NathanJustus/AmoeBotControl/Figures/amoeBotTesting.png

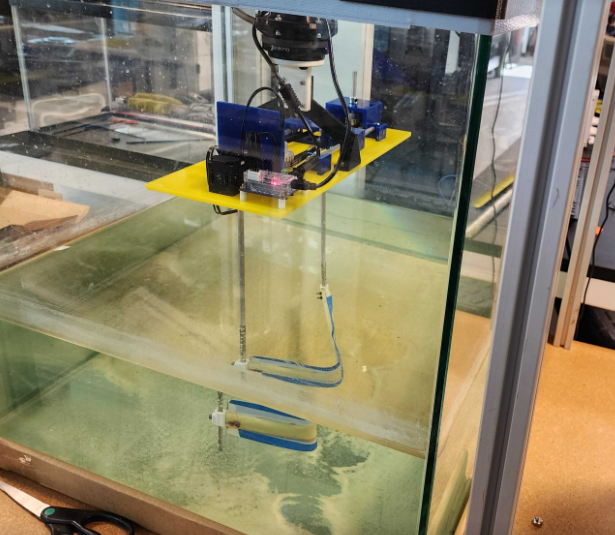
Figures/amoeBotTesting.png
