NathanJustus/AmoeBotControl/Figures/amoeBotConcept.png

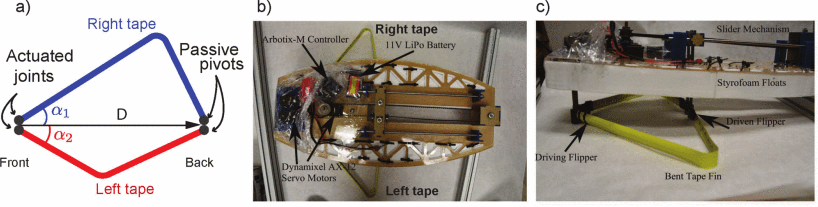
Figures/amoeBotConcept.png
