NathanJustus/AmoeBotControl/Figures/coefficientRegression.pdf

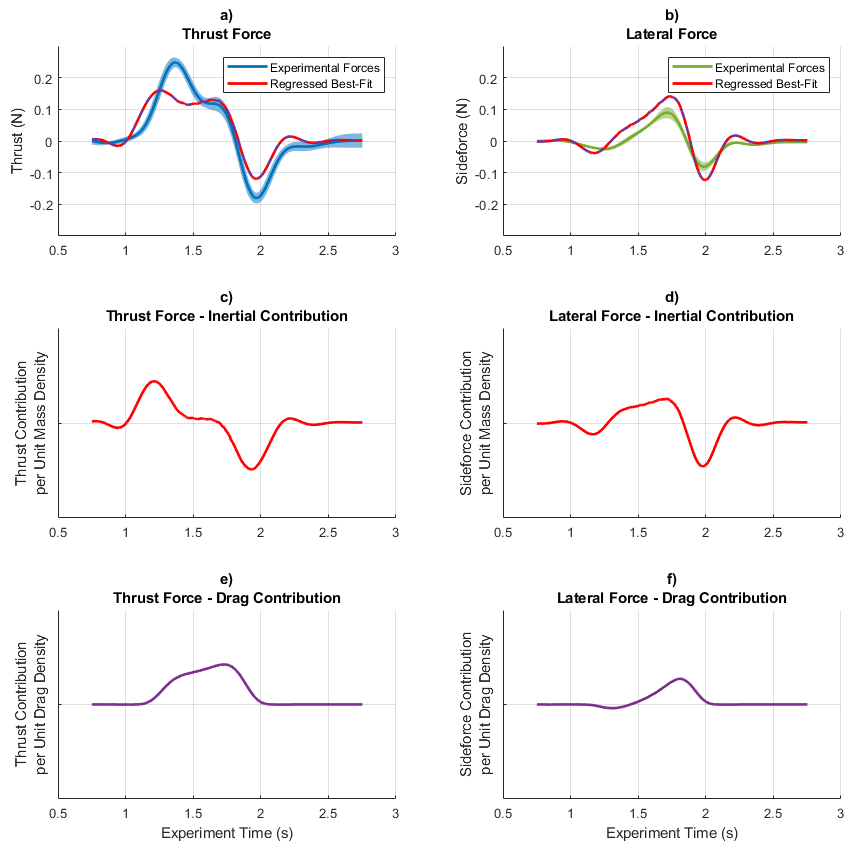
[picture p3: page 1]
