NathanJustus/AmoeBotControl/Figures/GaitCompilation.pdf

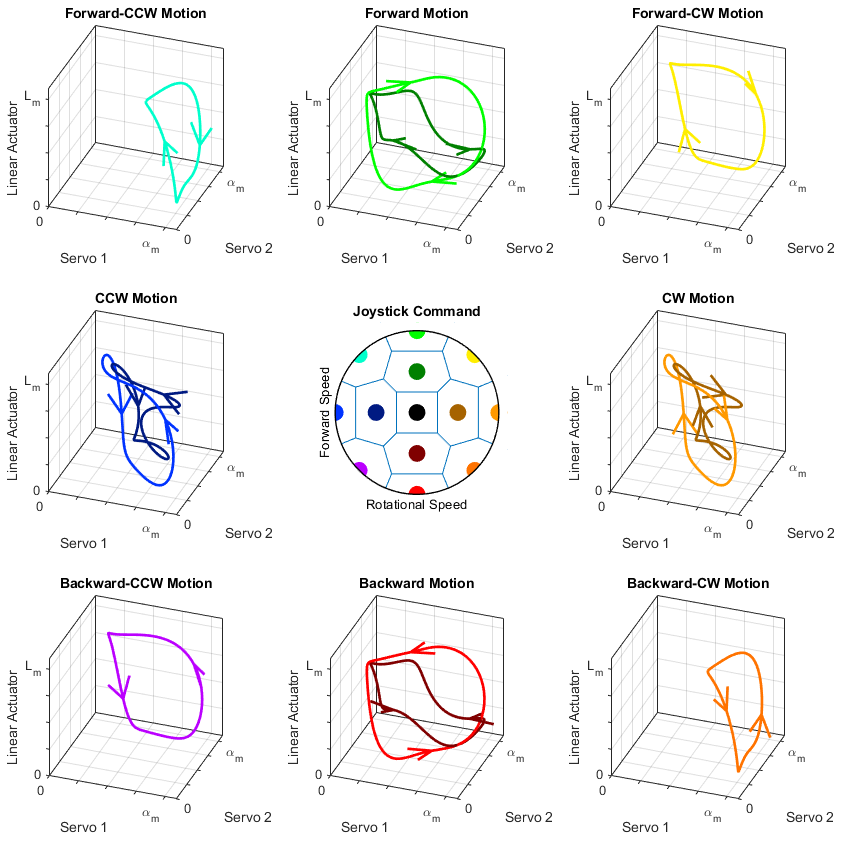
[picture p4: page 1]
