NathanJustus/AmoeBotControl/Figures/gaitControlExample.pdf

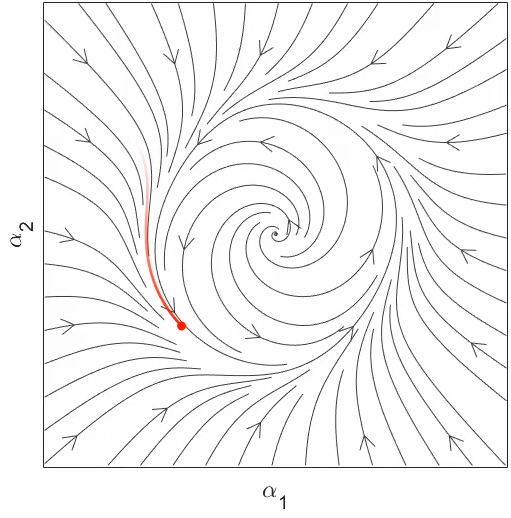
[picture p5: page 1]

Gait Control Field
Three-Link Swimmer Forward Gait
