NathanJustus/AmoeBotControl/Figures/pacingVisualization.pdf

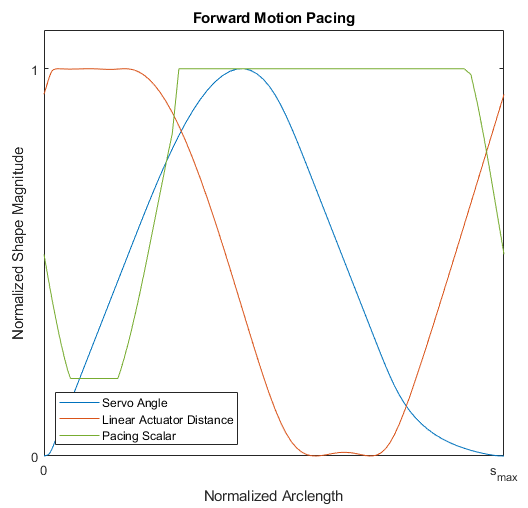
[picture p6: page 1]
