NathanJustus/AmoeBotControl/Figures/TapeGeometry.pdf

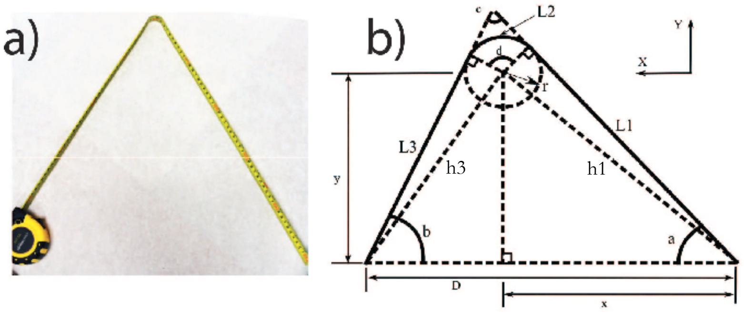
[picture p7: page 1]

h3 | h1
