NathanJustus/AmoeBotControl/Figures/WaypointNavigation.pdf

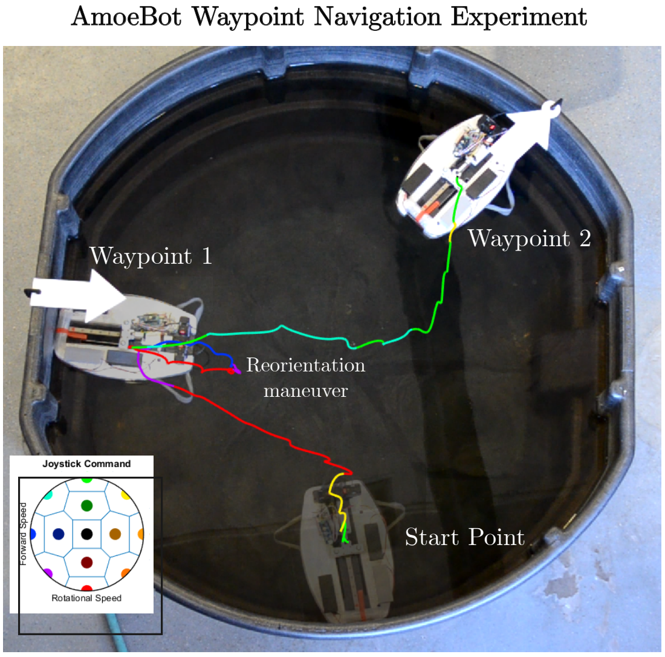
[picture p8: page 1]
Waypoint 1; Waypoint 2; Start Point; Reorientation maneuver

AmoeBot Waypoint Navigation Experiment
