NathanJustus/AmoeBotControl/DataExtraction/Animations/AmoeBotElementSweep.gif

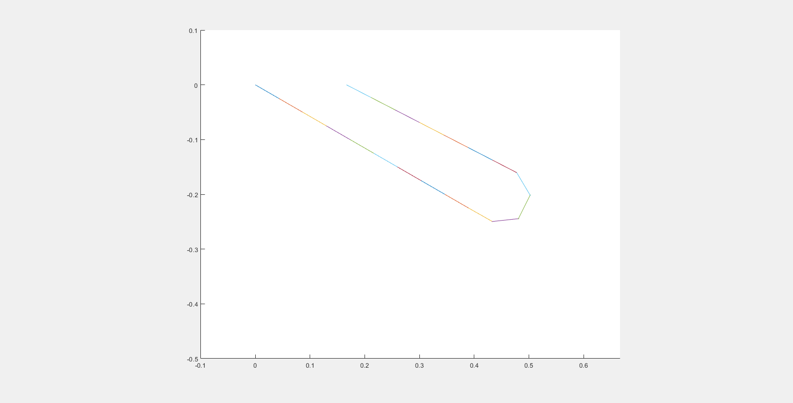
DataExtraction/Animations/AmoeBotElementSweep.gif
