NathanJustus/AmoeBotControl/DataExtraction/Animations/forceTraces_forward.png

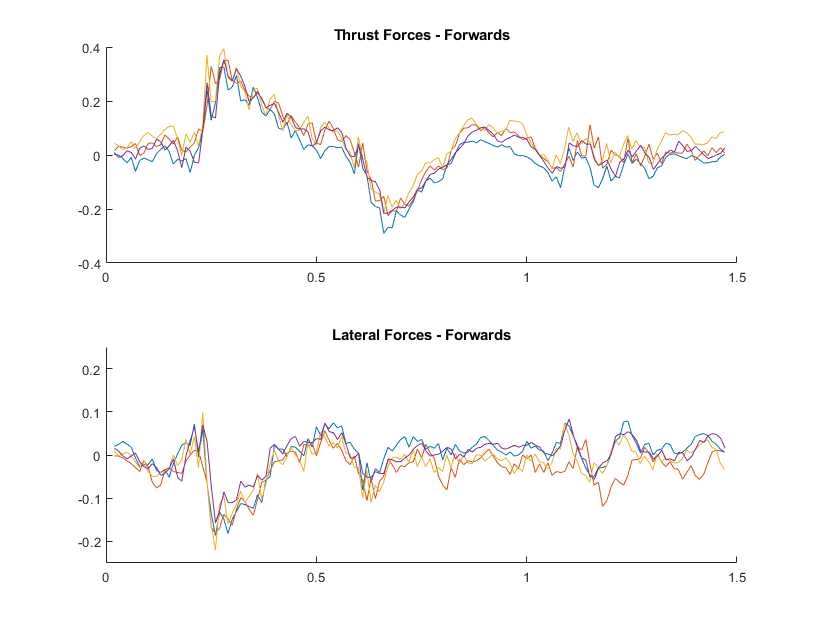
DataExtraction/Animations/forceTraces_forward.png
