NathanJustus/AmoeBotControl/DataExtraction/ApproximationComparison/approximationComparison.gif

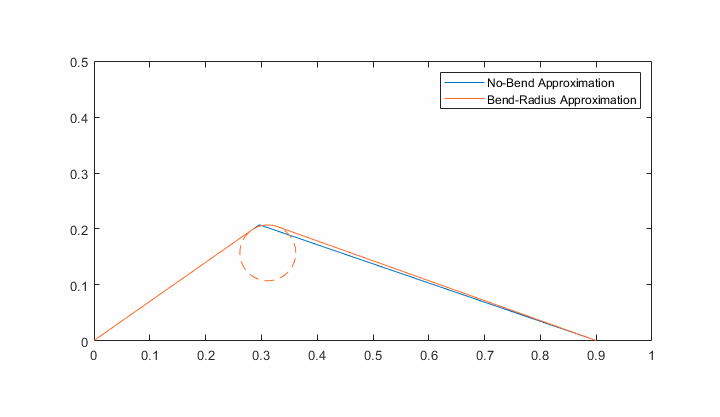
DataExtraction/ApproximationComparison/approximationComparison.gif
