NathanJustus/AmoeBotControl/DataExtraction/ApproximationComparison/approximationComparison_rectangle.gif

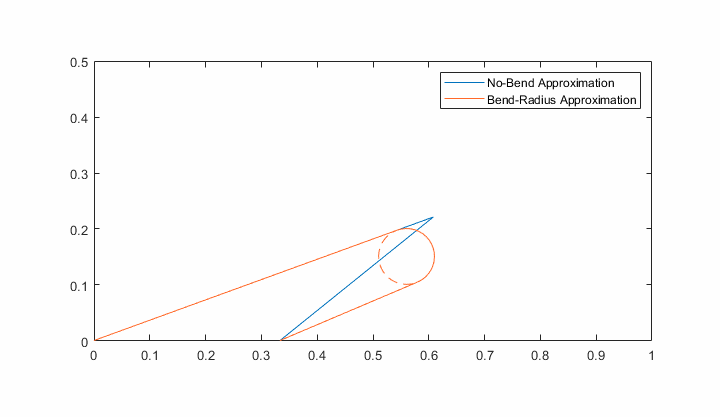
DataExtraction/ApproximationComparison/approximationComparison_rectangle.gif
