NathanJustus/AmoeBotControl/Figures/Unbuilt_AmoeniBot.jpg

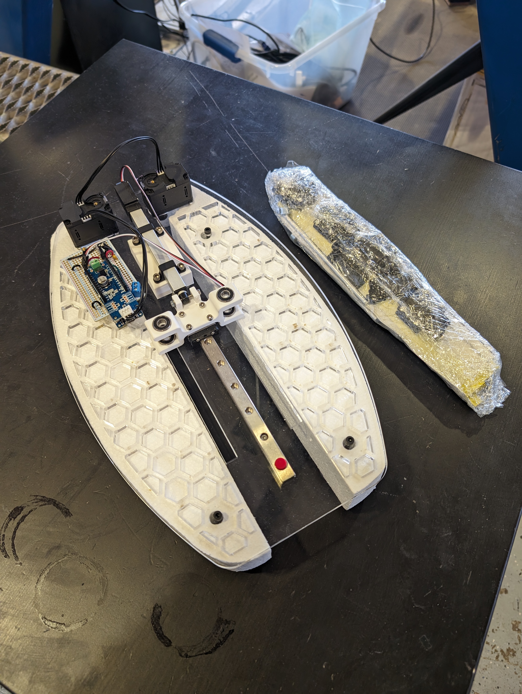
Figures/Unbuilt_AmoeniBot.jpg
