NathanJustus/AmoeBotControl/OptimalGaitGeneration/Animations/AmoeBot_Drift.gif

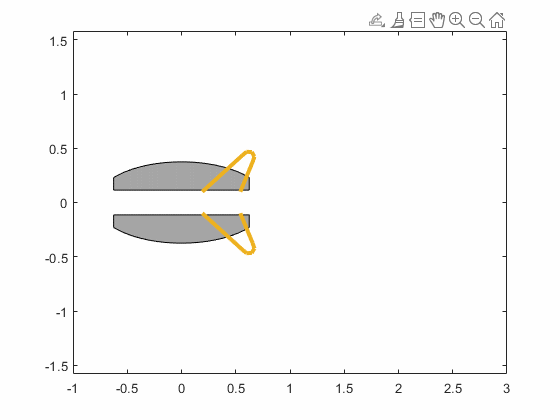
OptimalGaitGeneration/Animations/AmoeBot_Drift.gif
