NathanJustus/AmoeBotControl/OptimalGaitGeneration/Animations/ForwardGait_constantPace.gif

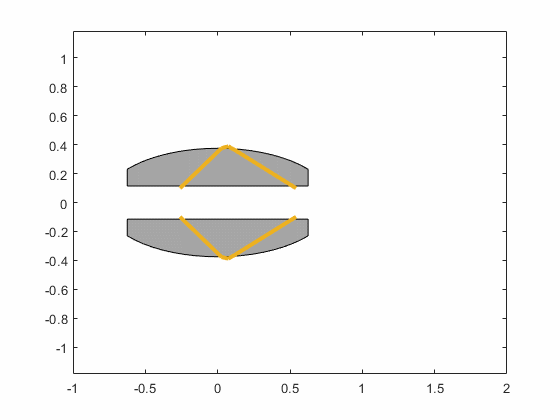
OptimalGaitGeneration/Animations/ForwardGait_constantPace.gif
