NathanJustus/AmoeBotControl/OptimalGaitGeneration/Animations/GaitLibrary.png

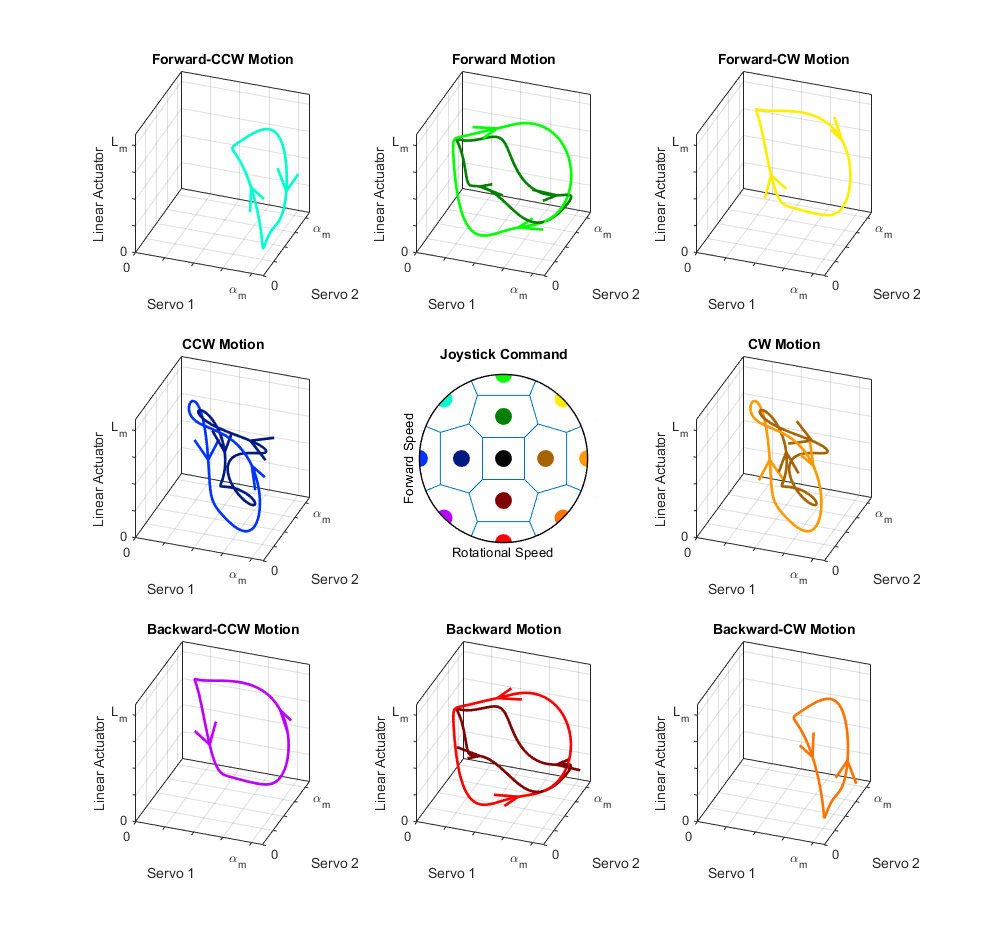
OptimalGaitGeneration/Animations/GaitLibrary.png
