NathanJustus/AmoeBotControl/OptimalGaitGeneration/sampleGait.gif

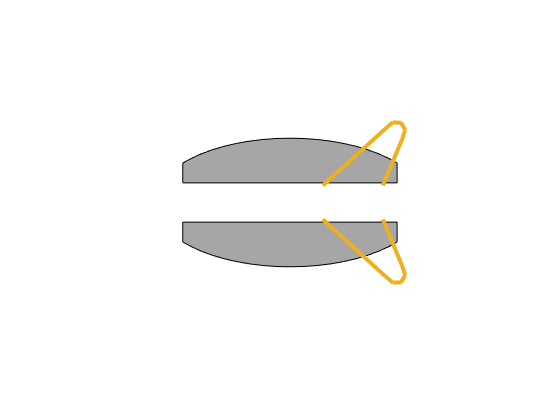
OptimalGaitGeneration/sampleGait.gif
