NathanJustus/AmoeBotControl/PrintFiles/SmallBatteryBoxTop_v2.SLDPRT

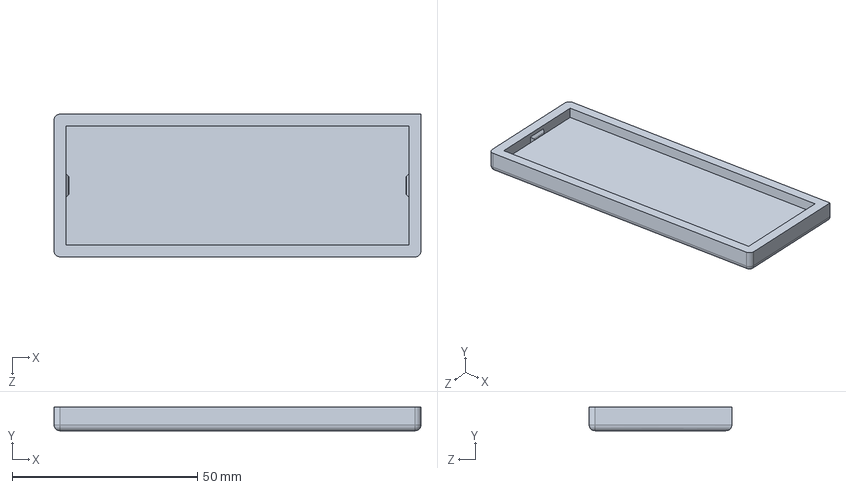
[picture p18: CAD file, 2024-06-11]
PrintFiles/SmallBatteryBoxTop_v2.SLDPRT
99.0 x 6.35 x 38.5 mm
