NathanJustus/AmoeBotControl/PrintFiles/TwoSidedTapeDriver.stl

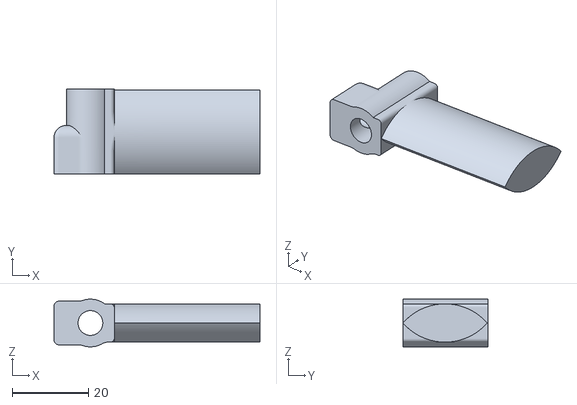
[picture p19: CAD file, 2024-06-11]
PrintFiles/TwoSidedTapeDriver.stl
53.9 x 22.2 x 12.5
