NathanJustus/AmoeBotControl/PrintFiles/BigBatteryBoxTop.SLDPRT

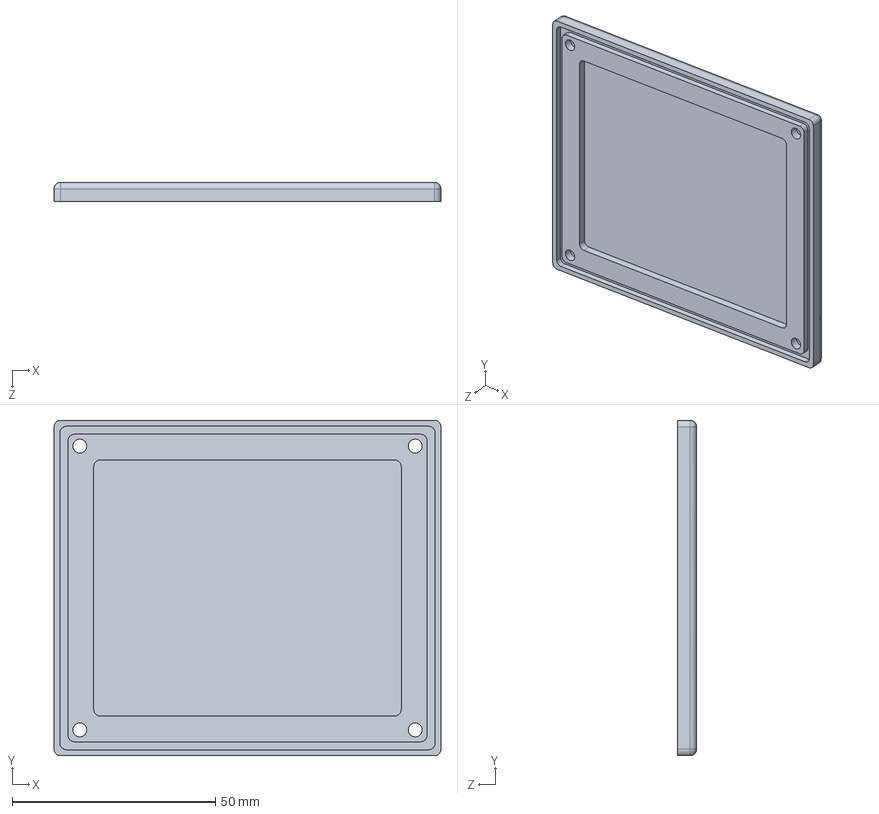
[picture p20: CAD file, 2024-06-11]
PrintFiles/BigBatteryBoxTop.SLDPRT
95.2 x 82.5 x 4.76 mm
