NathanJustus/AmoeBotControl/PrintFiles/SmallBatteryBoxTop.SLDPRT

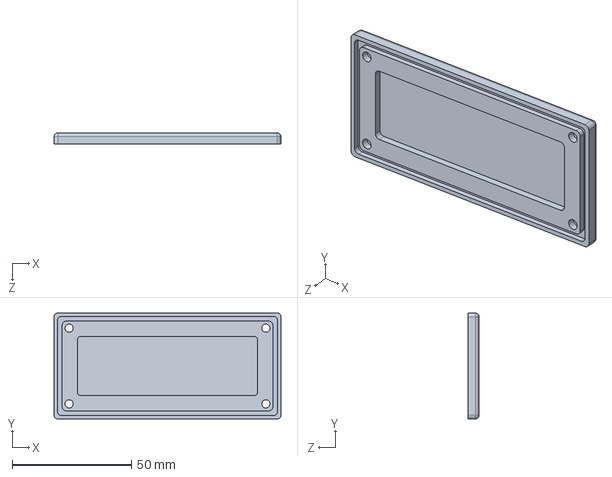
[picture p21: CAD file, 2024-06-11]
PrintFiles/SmallBatteryBoxTop.SLDPRT
95.2 x 44.5 x 4.75 mm
