NathanJustus/AmoeBotControl/PrintFiles/ArrowInward.SLDPRT

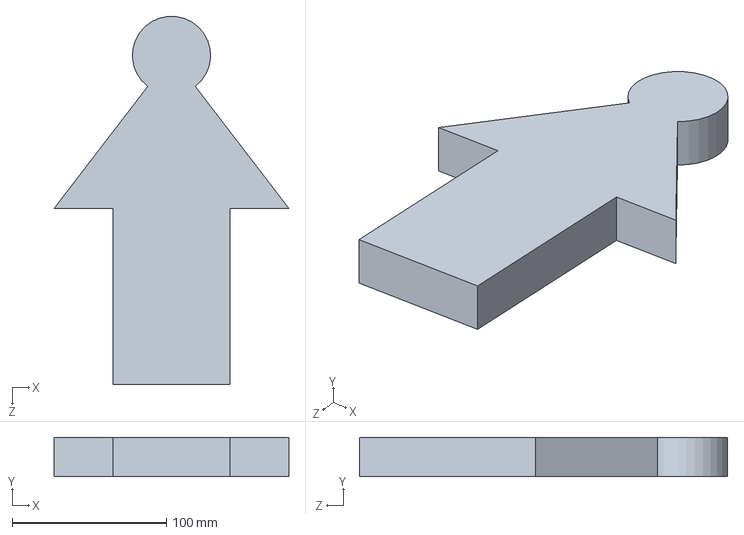
[picture p22: CAD file, 2024-06-11]
PrintFiles/ArrowInward.SLDPRT
152.4 x 25.4 x 238.9 mm
