NathanJustus/AmoeBotControl/PrintFiles/SmallBatteryBoxBottom.SLDPRT

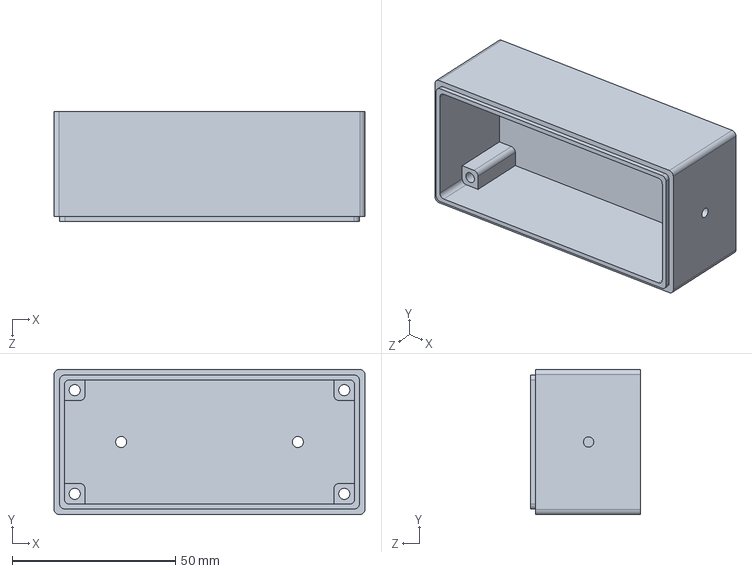
[picture p23: CAD file, 2024-06-11]
PrintFiles/SmallBatteryBoxBottom.SLDPRT
95.2 x 44.5 x 33.7 mm
