NathanJustus/AmoeBotControl/PrintFiles/BigBatteryBoxBottom.SLDPRT

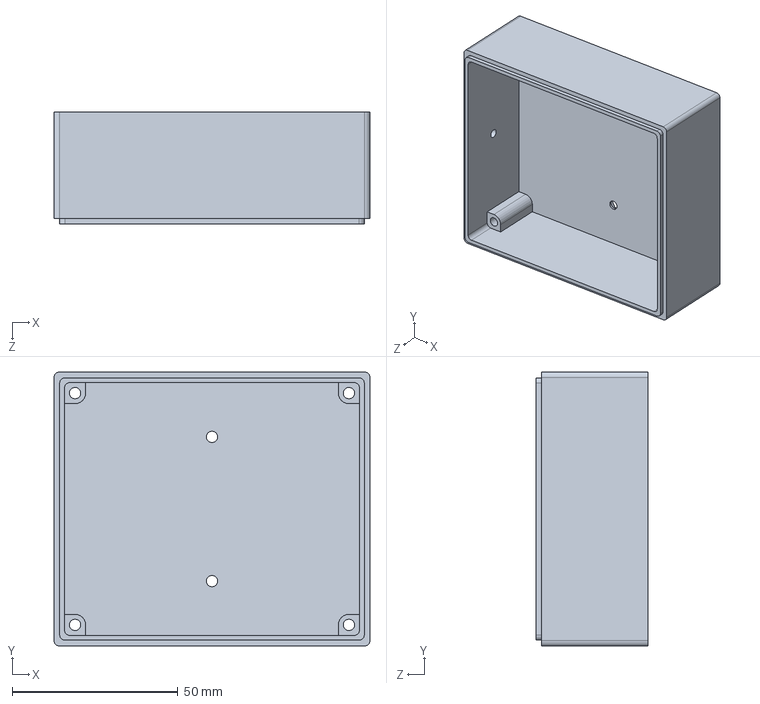
[picture p24: CAD file, 2024-06-11]
PrintFiles/BigBatteryBoxBottom.SLDPRT
95.2 x 82.5 x 33.7 mm
