NathanJustus/AmoeBotControl/PrintFiles/BigBatteryBox.3mf

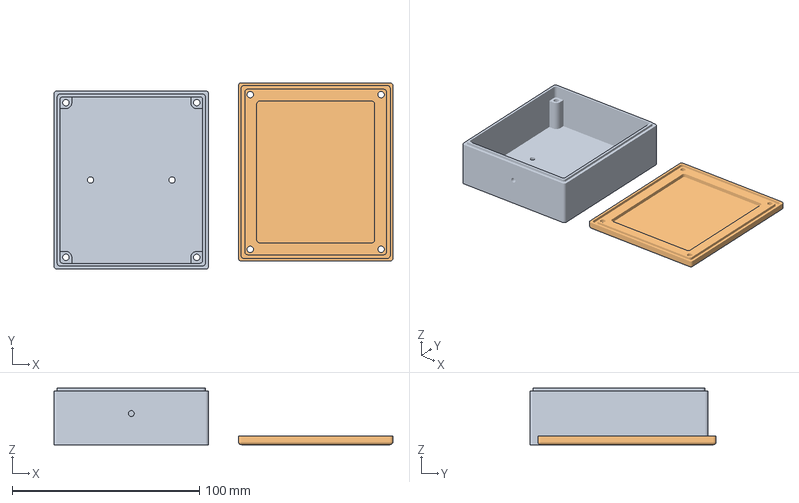
[picture p25: CAD file, 2024-06-11]
PrintFiles/BigBatteryBox.3mf
181.0 x 99.5 x 30.2 mm
BigBatteryBoxBottom.STL
BigBatteryBoxTop.STL
