NathanJustus/AmoeBotControl/PrintFiles/ArrowOutward.SLDPRT

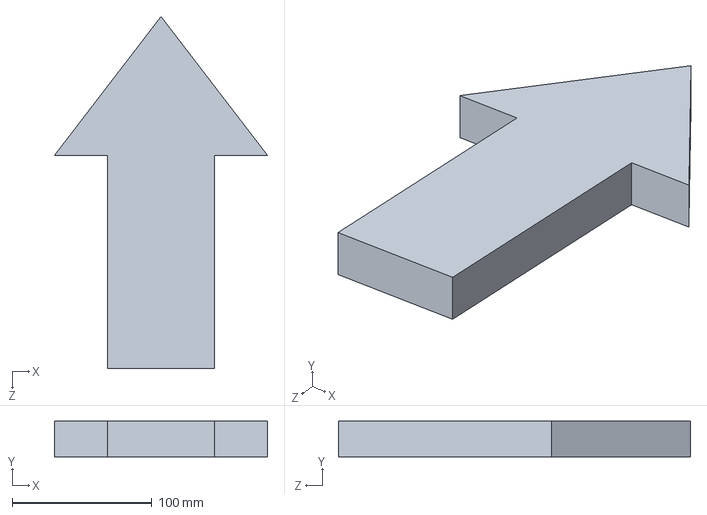
[picture p26: CAD file, 2024-06-11]
PrintFiles/ArrowOutward.SLDPRT
152.4 x 25.4 x 251.7 mm
