NathanJustus/AmoeBotControl/PrintFiles/CircleMarker.DXF

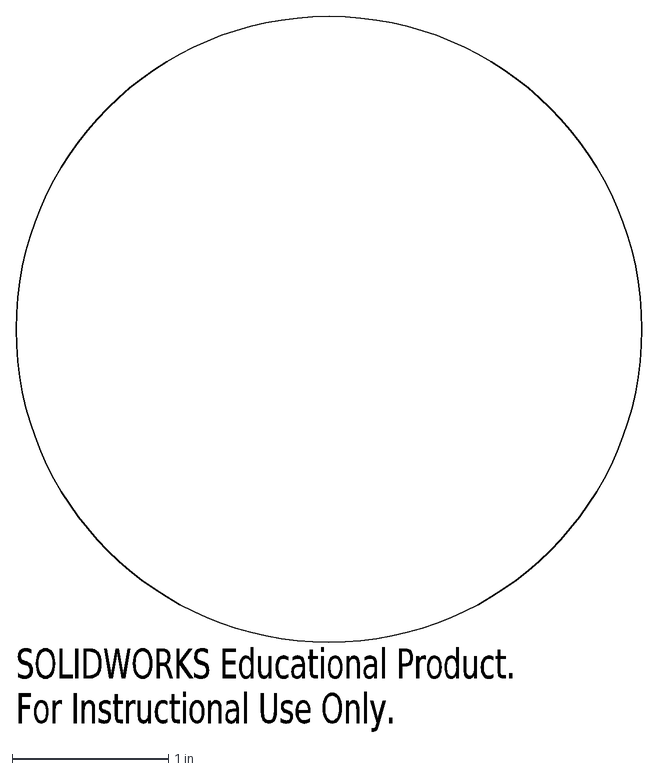
[picture p27: CAD file, 2024-06-11]
PrintFiles/CircleMarker.DXF
SOLIDWORKS Educational Product.
For Instructional Use Only.
