NathanJustus/AmoeBotControl/PrintFiles/SmallBatteryBoxBottom_v2.SLDPRT

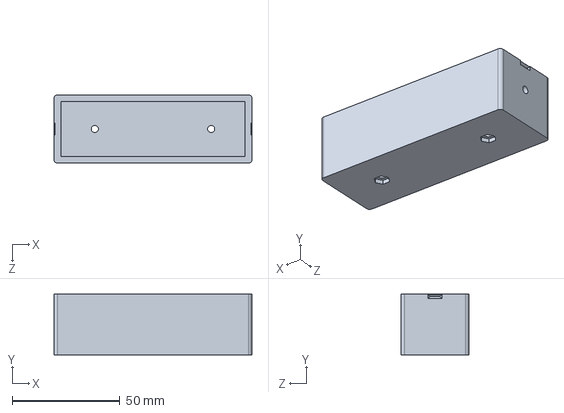
[picture p28: CAD file, 2024-06-11]
PrintFiles/SmallBatteryBoxBottom_v2.SLDPRT
92.1 x 28.2 x 31.8 mm
