NathanJustus/AmoeBotControl/(list of files, cad)

Other CAD files:
PrintFiles/BigBatteryBoxBottom.SLDPRT.STL
PrintFiles/ArrowInward.DXF
PrintFiles/ArrowOutward.DXF
PrintFiles/BigBatteryBoxBottom.STL
PrintFiles/BigBatteryBoxTop.STL
PrintFiles/SmallBatteryBoxBottom.STL
PrintFiles/SmallBatteryBoxBottom_v2.STL
PrintFiles/SmallBatteryBoxTop.STL
PrintFiles/SmallBatteryBoxTop_v2.STL
