NathanJustus/AmoeBotControl/Figures/ForceExperiment.pdf

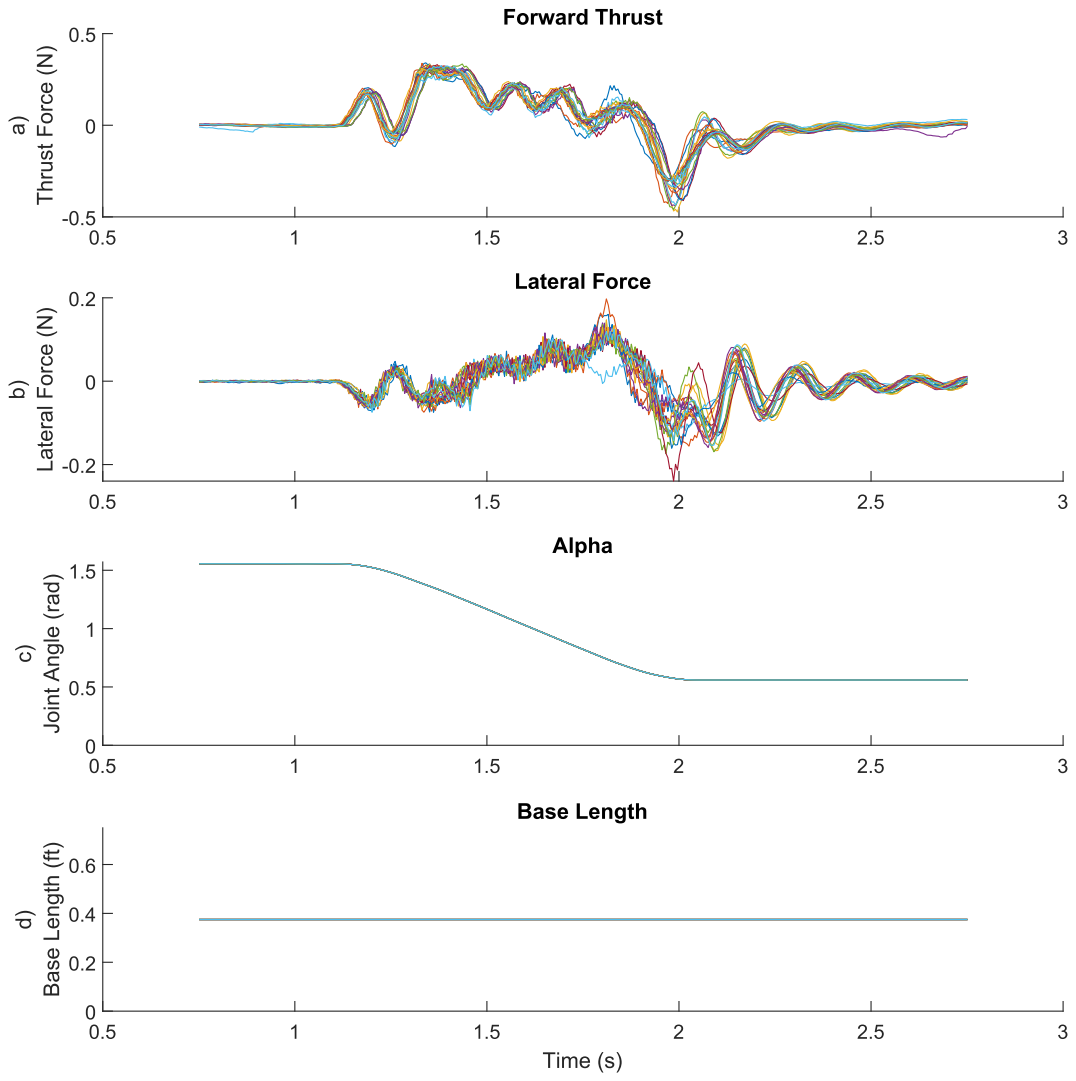
[picture p29: page 1]
