NathanJustus/AmoeBotControl/Figures/simpleModel.pdf

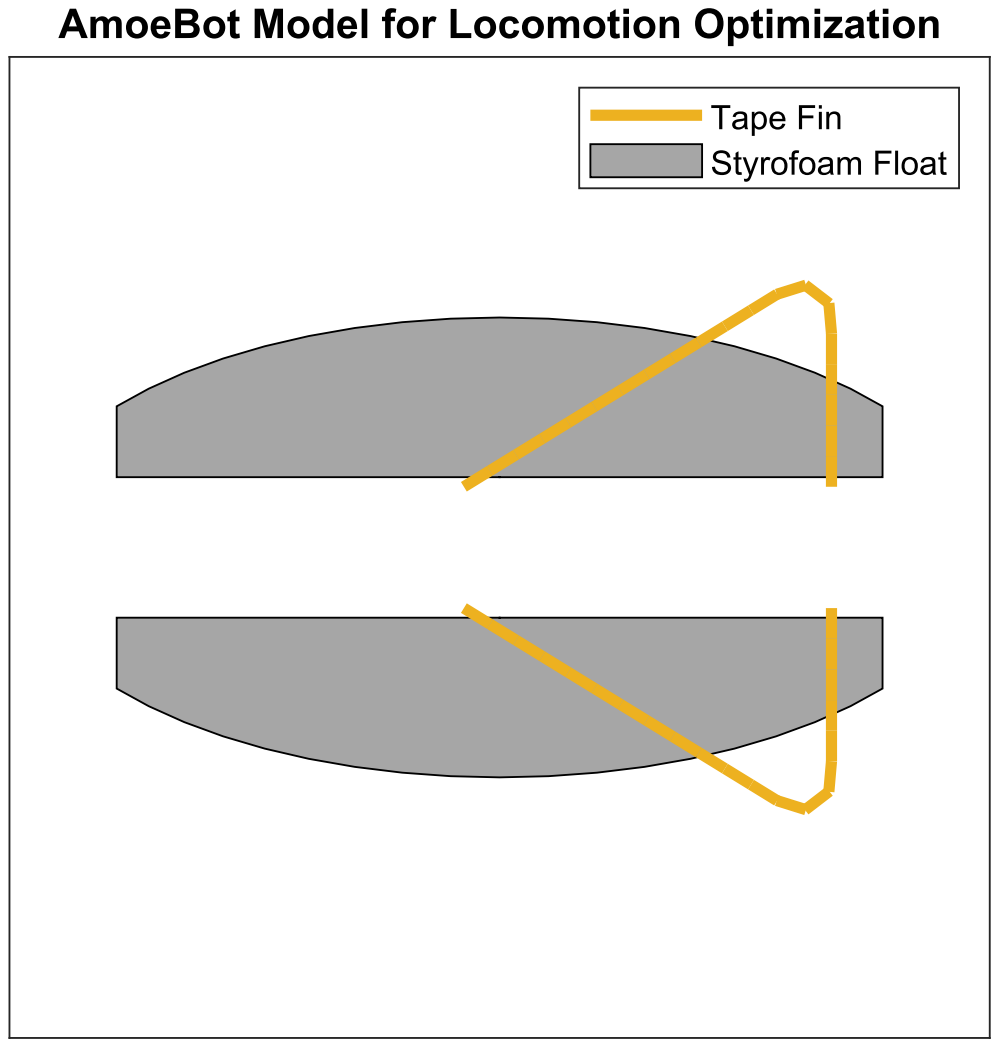
[picture p30: page 1]
