NathanJustus/AmoeBotControl/Figures/FigureEightResults.pdf

## AmoeBot Figure-Eight Experiment

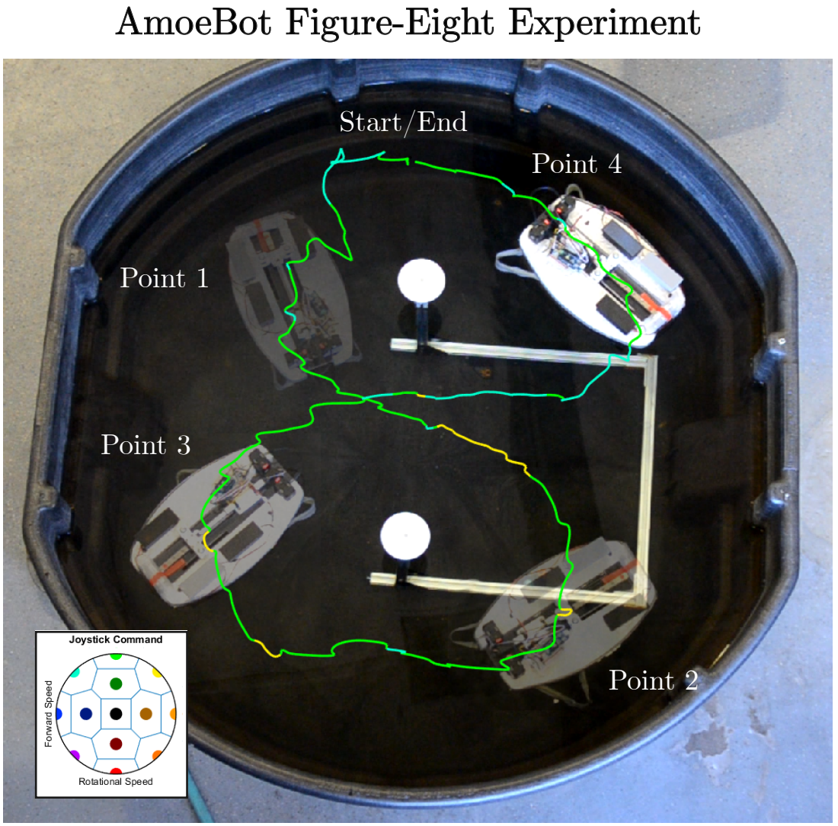
[picture p32: page 1]
Start/End; Point 4; Point 3; Point 2; Point 1
