NathanJustus/AmoeBotControl/DataExtraction/Animations/amoeBotExperimentVisualization_take2.gif

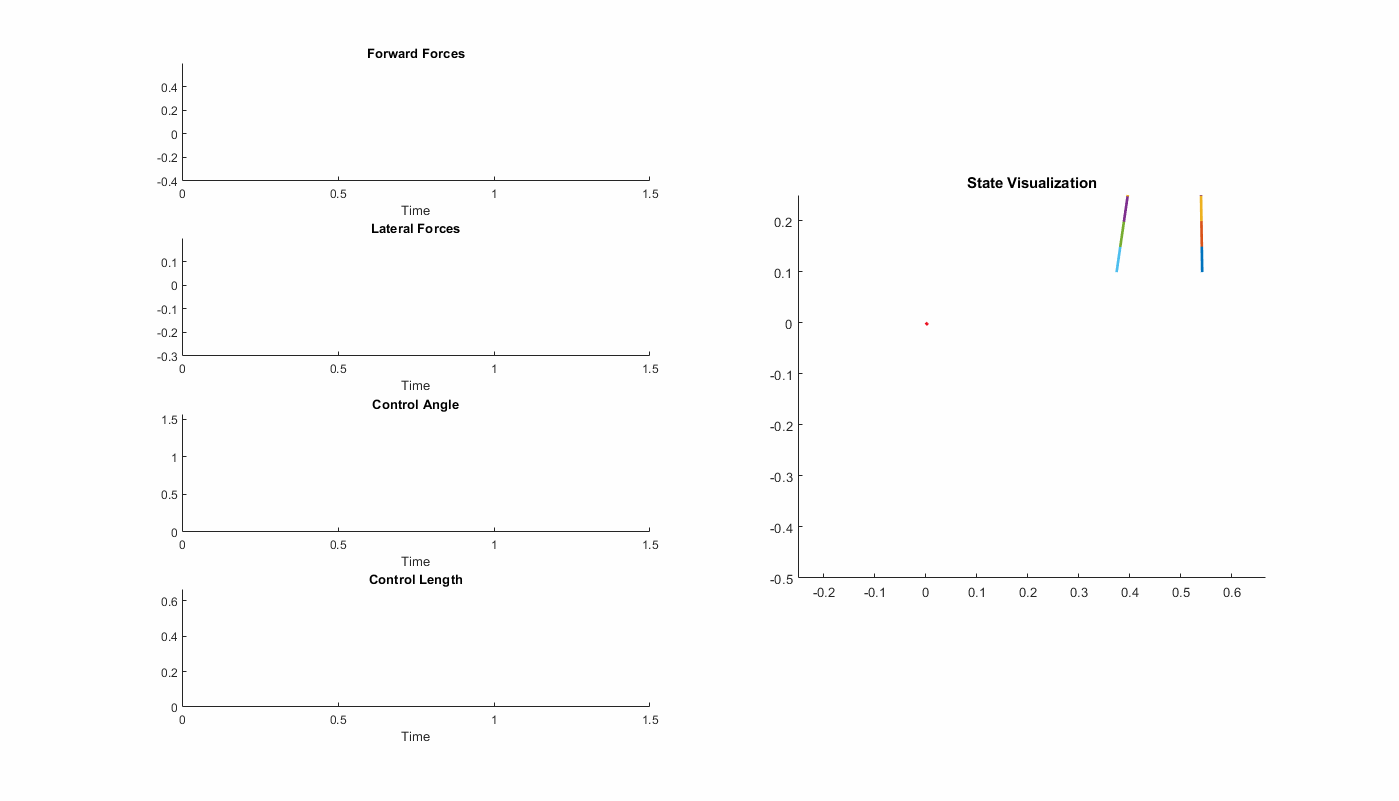
DataExtraction/Animations/amoeBotExperimentVisualization_take2.gif
